FabianIDE/sports-wheelchair-project/Images/Photos/IMG_20190405_152254.jpg

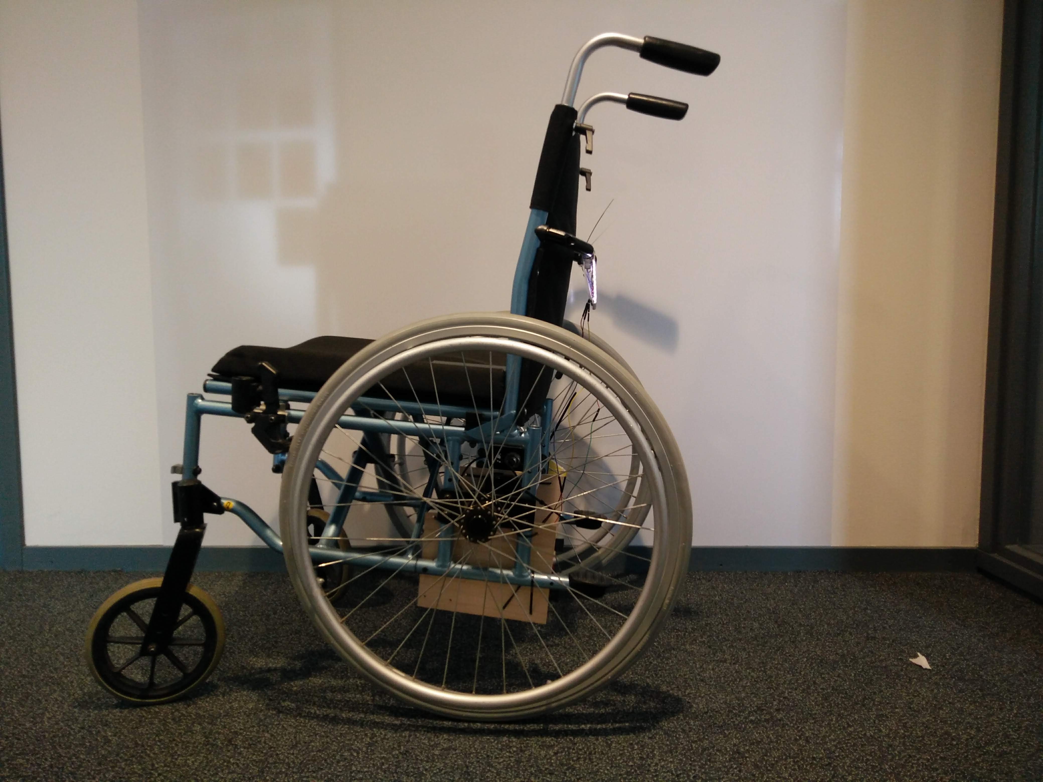
Images/Photos/IMG_20190405_152254.jpg
