FabianIDE/sports-wheelchair-project/Images/Photos/IMG_20190405_152532.jpg

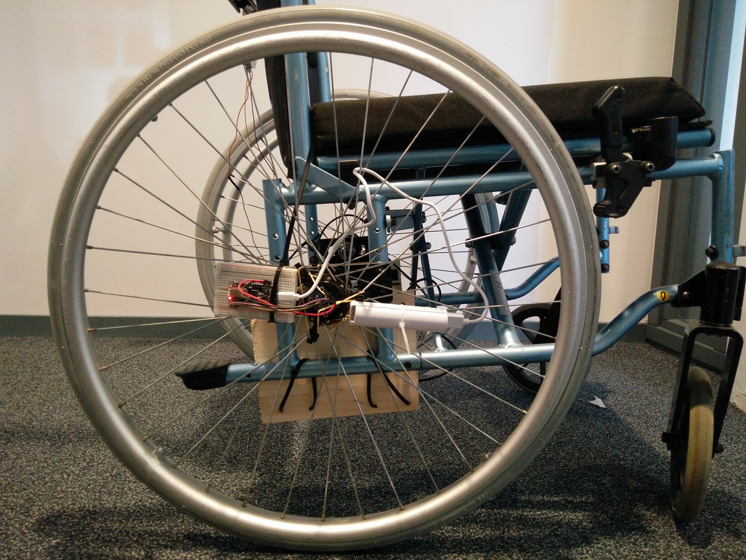
Images/Photos/IMG_20190405_152532.jpg
