FabianIDE/sports-wheelchair-project/Images/Photos/IMG_20190408_144844.jpg

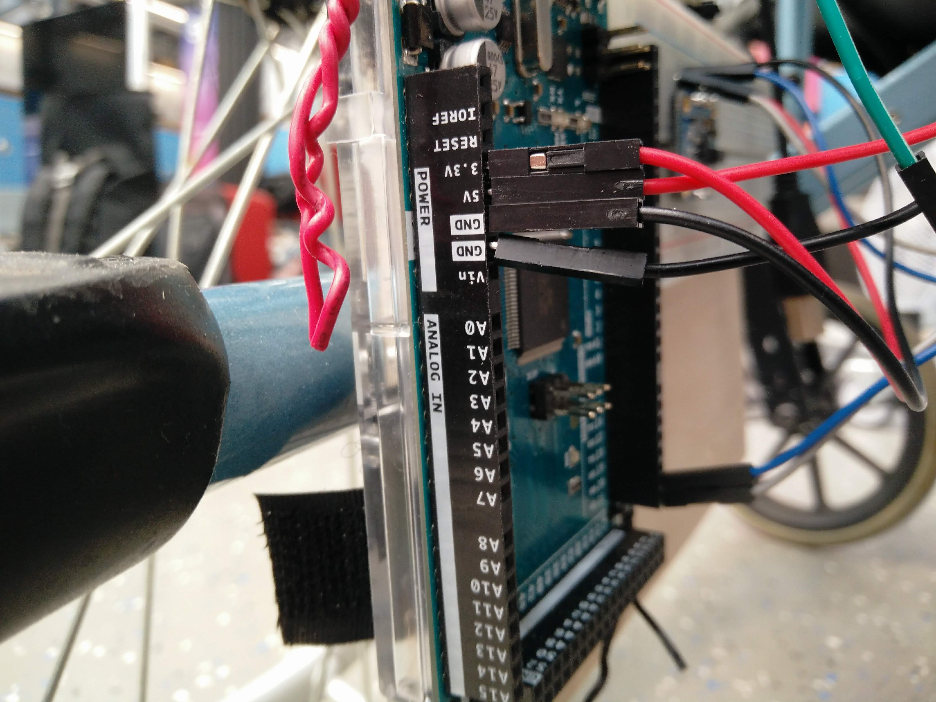
Images/Photos/IMG_20190408_144844.jpg
