FabianIDE/sports-wheelchair-project/Images/Photos/IMG_20190408_144847.jpg

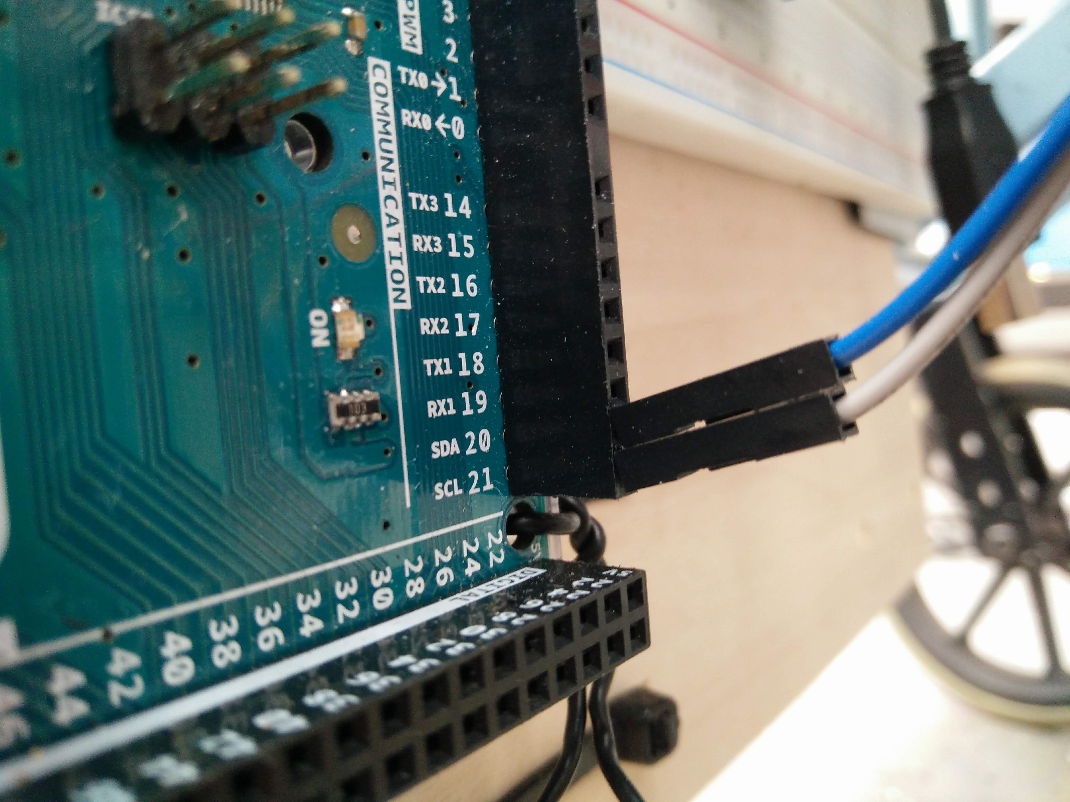
Images/Photos/IMG_20190408_144847.jpg
