FabianIDE/sports-wheelchair-project/wheelchair/magnets arduino/Arduino layout.png

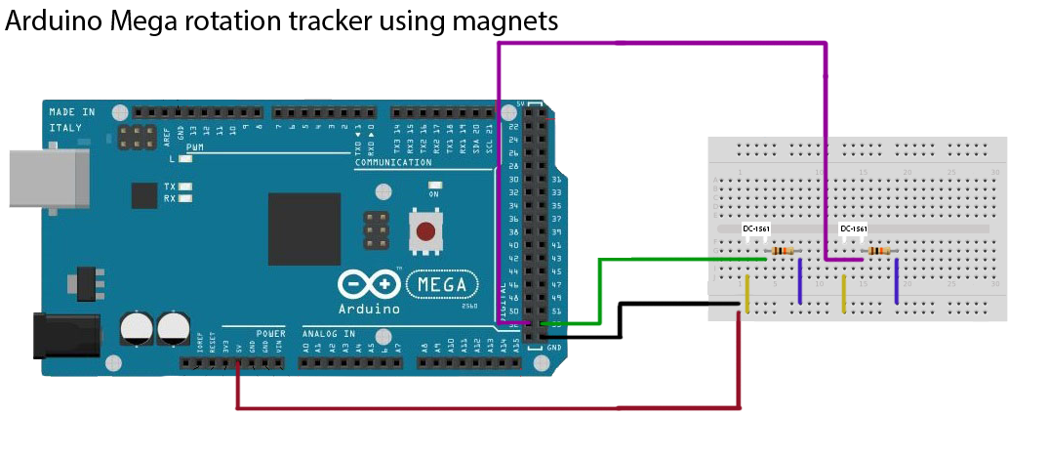
wheelchair/magnets arduino/Arduino layout.png
