FabianIDE/sports-wheelchair-project/wheelchair/magnets arduino/IMG_20190304_154146.jpg

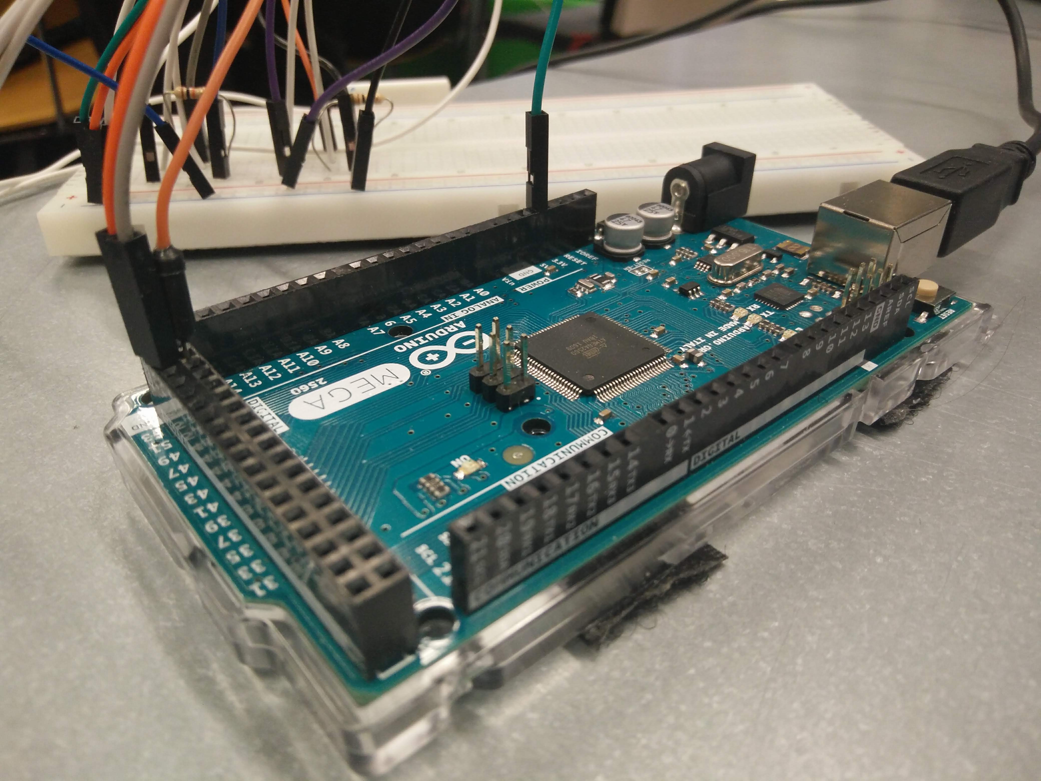
wheelchair/magnets arduino/IMG_20190304_154146.jpg
