FabianIDE/sports-wheelchair-project/INSTALLATION.md

#### MENU

[Project Description](README.md) - [Sensors & Actuators](SENSORS_ACTUATORS.md) - [Components](COMPONENTS.md) - [Installation](INSTALLATION.md) - [Testing](TESTING.md) -  [Changelog](CHANGELOG.md)

## INSTALLATION

 After collecting all the components as specified in [Components](COMPONENTS.md), follow these steps how to set everything up.

### Arduino

Download and install the (latest) Arduino software from the Arduino website (we used v 1.8.5) https://www.arduino.cc/en/Main/Software

###### Boards
The Arduino IDE already comes with everything needed for the Arduino Mega.

The Bluefruit board does need to be added manually:

Go to Tools -> Boards -> Boards Manager
Search for "bluefruit"
Install both the "adafruit AVR boards" and the "Adafruit nRF52".

Now the bluefruit should show up in your Tools -> Boards listed.

###### Libraries
In order to run the arduino sketches on this repository, the following libraries need to be install through Sketch -> Include Library -> Manage Libraries.
Search for "bluefruit nFF51" and click install.
Search for "adafruit BNO055" and click install.

###### Upload sketches
Upload the latest code in the SportsTracker_V1_Stable -> Arduino Mega folder to the Arduino Mega through the Arduino IDE.

Upload the latest code in the SportsTracker_V1_Stable -> BLE_Feather folder to the Bluefruit through the Arduino IDE.

### Raspberry Pi

Power up and connect to your Raspberry Pi in the way you prefer (i.e. over SSH or connect it to a monitor)

###### Install python requirements
Install the requirements as listed in the requirements.txt file through its terminal

```bash
pip3 install -r requirements.txt --user
```

Now install the Bluetooth dependencies for Python:

```bash
apt-get install bluez libbluetooth-dev

pip3 install git+https://github.com/peplin/pygatt

pip3 install "pygatt[GATTTOOL]"

pip3 install bluepy

pip3 install pexpect
```

###### Scan for BLE for the feather and HRM to find MAC address

We can use the command 'blescan' to scan the Bluetooth devices around. This way,you can retrieve your Feather 32u4 and the HRM (Mio link) and identify its MAC address.

```bash
sudo blescan
```

Copy the MAC addresses and paste in your .env file as a new environment variables
'BLUETOOTH_DEVICE_MAC_HRM' and 'BLUETOOTH_DEVICE_MAC_WHEEL', **for example**:

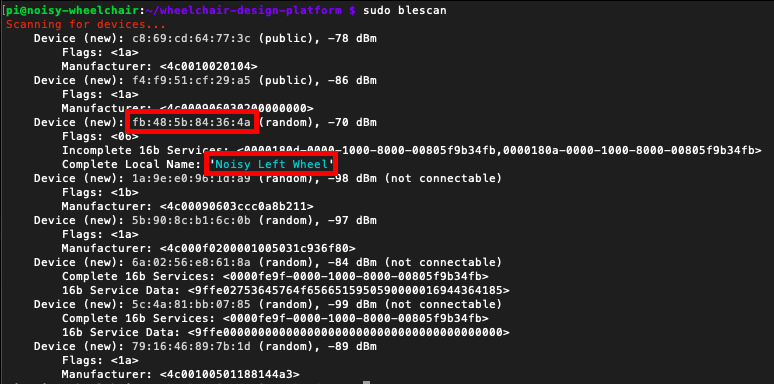
[picture p17: Archive/Course_resources/docs/workshops/images/ws2_blescan.png]
blescan


```bash
BLUETOOTH_DEVICE_MAC_HRM=C5:46:4C:2F:AD:C6
BLUETOOTH_DEVICE_MAC_WHEEL=C5:46:4C:2F:AD:C6
```

### Connecting all the components

##### On the Wheel
Connect the Bluefruit with some jumper wires to the BNO055 using this schematic:

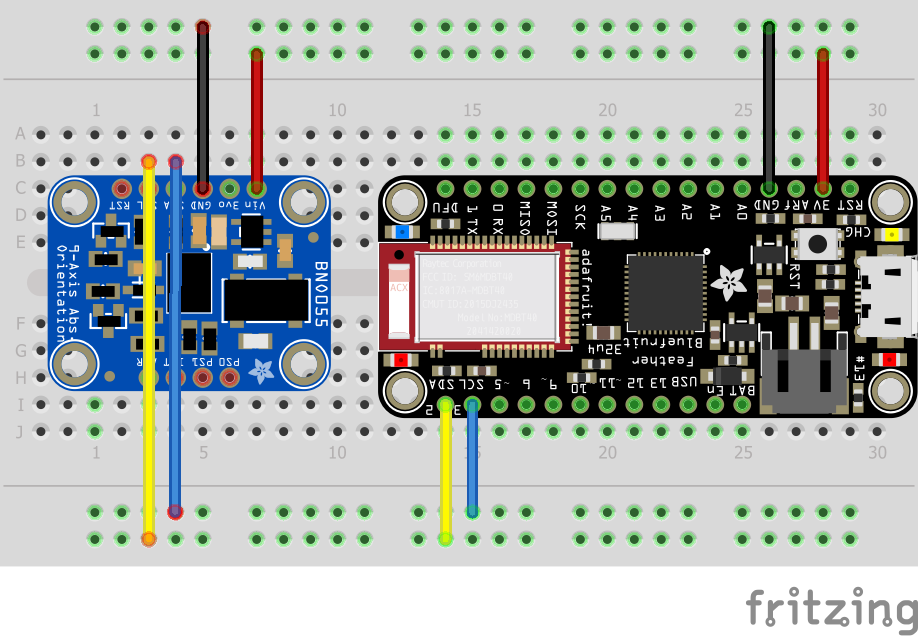
[picture p18: Images/Image 3_feather+BNO.png]


Connect the Bluefruit to the powerbank using the micro USB cable.

Now attach the whole assembly to the right wheel of the wheelchair.
**Make sure to attach the BNO055 to the center of the wheel's axle**
The result should look something like this:

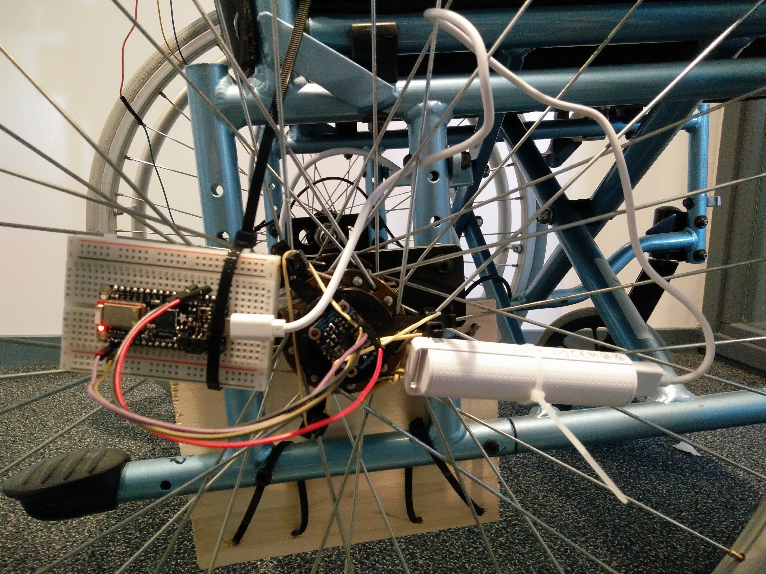
[picture p19: Images/Photos/IMG_20190405_152401.jpg]


##### On your wrist

Put the Heartbeat sensor on your wrist, then push and hold the button to turn it on.
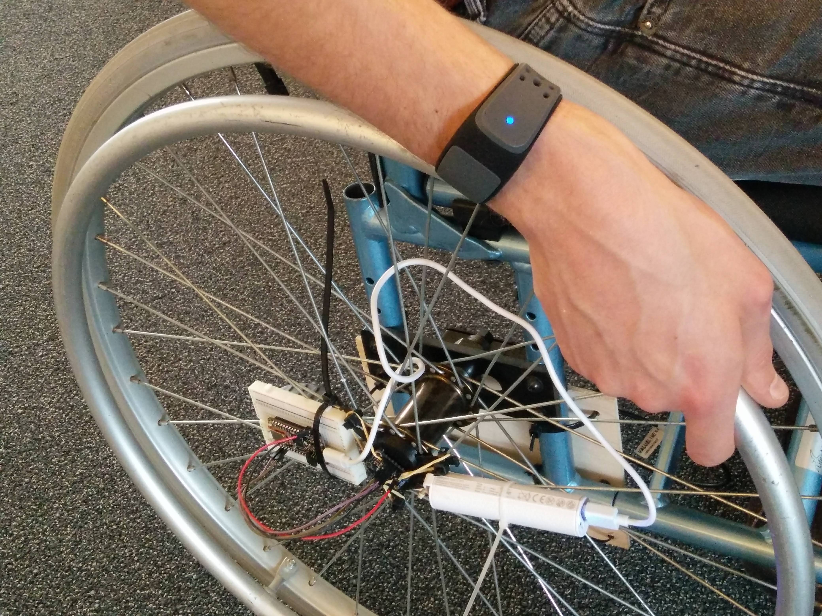
[picture p20: Images/Photos/IMG_20190405_153005.jpg]


##### Below the chair

The Arduino Mega must be connected to the other BNO055 and the LED ring. Use the following schematics to do so:

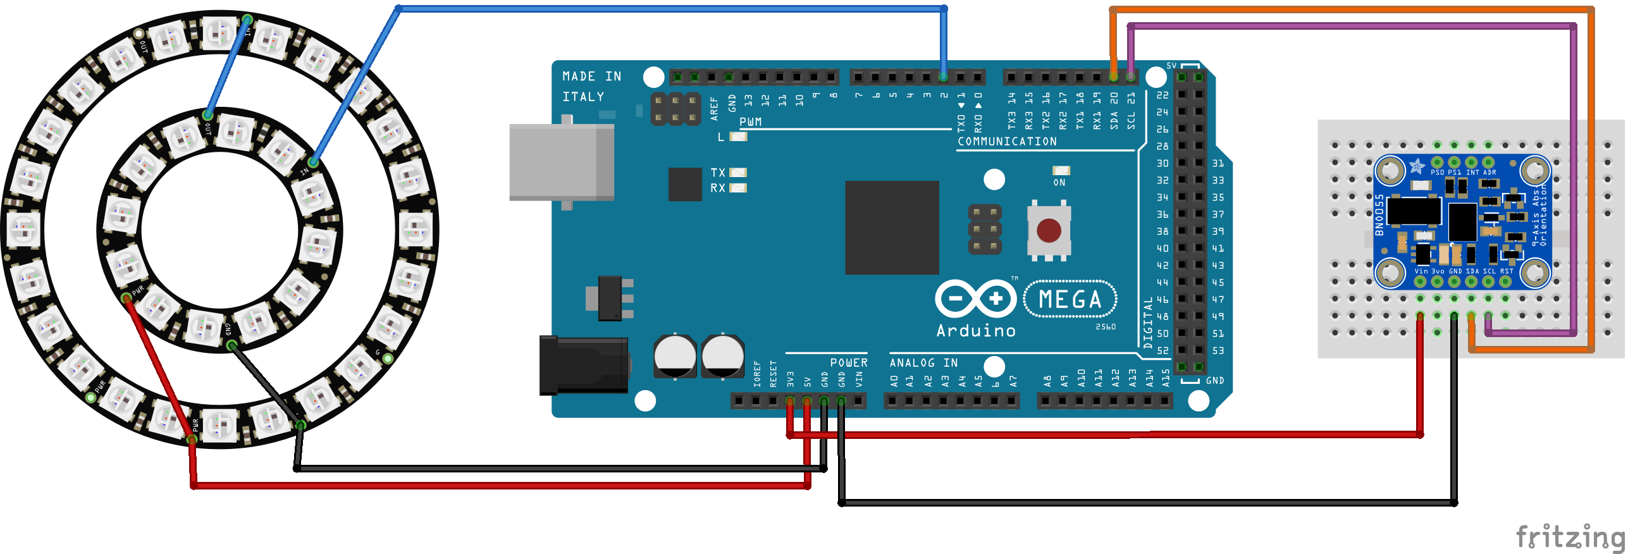
[picture p21: Images/ArduinoMega.png]


Now mount the LED ring to the back of the wheelchair and the BNO055 in the orientation shown in the picture. The location of the Arduino mega itself is not as important.

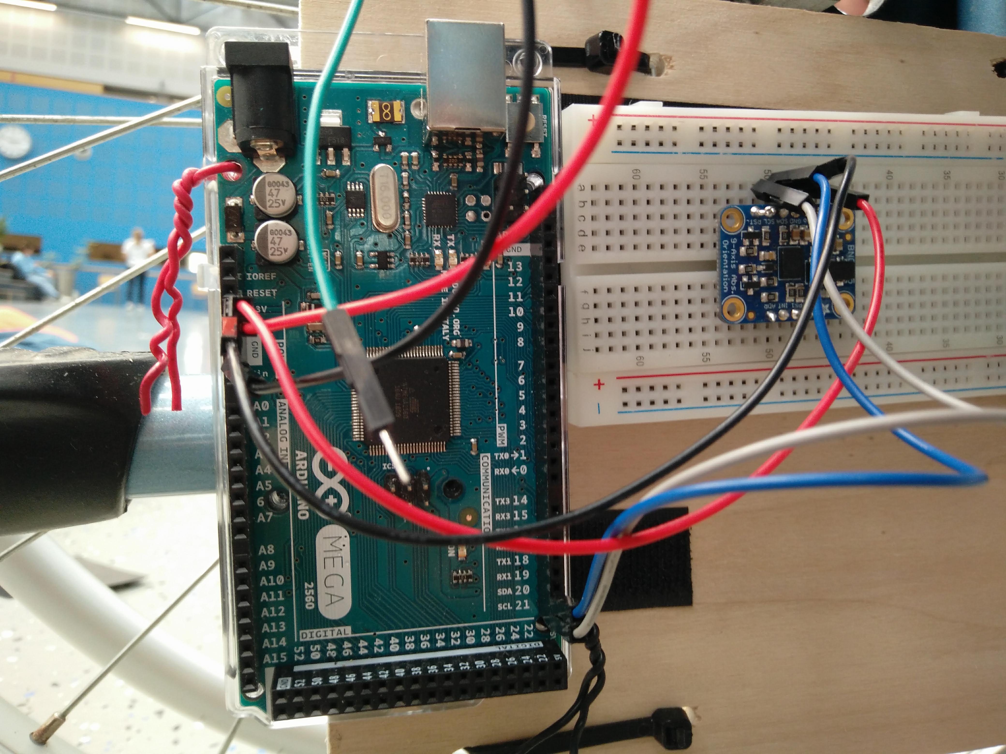
[picture p22: Images/Photos/IMG_20190408_144836.jpg]


Now mount the Raspberry Pi to the chair.
Connect the Raspberry Pi to the Arduino Mega with the USB cable
And finally mount the powerbank and connect it to the Raspberry Pi.

##### Running the Script
Make sure the Feather Bluefruit and the Heartbeat sensor is turned on.
Then run the latest SportsTracker V1_Stable/RaspberryPi -> Rpi_SportsWheelchair.py  script on the Raspberry Pi!

It should automatically detect and connect to all the peripherals. If you encounter an error or a timeout, reset the Bluefruit and the Heartbeat monitor before running the script again.
