FabianIDE/sports-wheelchair-project/TODO 15.04.2019.txt

-	Update GitHub documentation
	-	A person should be able to read and reproduce the prototype in a few hours

FABIAN
	-	Story															CHECK
	-	Video															NEEDS TO BE UPLOADED BY DANIEL
	-	Poster														CHECK
	- What tests have we done						CHECK
	- Who contributed										CHECK
	-	Github markup											CHECK
	- Github pages 											CHECK

DANIEL
	- Upload video
	- Embed video in README.md page

MAX
	-	Instructions python dependencies 	CKECK
	-	Wiring of hardware								CHECK
	-	LED RING													CHECK
	-	What is the purpose of the code
	-	Remove unnecessary code						CHECK
