FabianIDE/sports-wheelchair-project/(list of files, drawings)

Other design files:
Archive/Course_resources/docs/resources/sensors/images/force.fzz
Archive/Course_resources/docs/workshops/images/push_button_led_log.fzz
