FabianIDE/sports-wheelchair-project/wheelchair/push_button_led_log/push_button_led_log.ino

int BUTTON_PIN = 22;   // choose the input pin for the push button
int LED_PIN = 13;      // Choose the output pin for the LED

long LONG_PRESS_TIME = 500; // How long is a 'long press' (minimum, in ms)

long buttonActiveSince = 0; // Since when the button has been pressed (in ms since Arduino started)
boolean longPressActive = false; // Are we currently in a 'long press' event

void setup() {
  pinMode(BUTTON_PIN, INPUT);    // declare pushbutton as input
  pinMode(LED_PIN, OUTPUT);      // declare LED as input

  Serial.begin(9600); // setting baud speed for Serial (a baud is a pulse)


}

void loop() {
  // Is button active?
  if (digitalRead(BUTTON_PIN) == LOW) {
    // if the button was not yet pressed
    if (buttonActiveSince == 0) {
        buttonActiveSince = millis();
    } else if ((millis() - buttonActiveSince > LONG_PRESS_TIME)
                && longPressActive == false) {
      longPressActive = true;
      digitalWrite(LED_PIN, HIGH);  // turn LED ON
    }

  // Was button active?
  } else {
    // Was Long Press event?
    if (buttonActiveSince > 0) {
      // End Long Press event
      if (longPressActive == true) {
        Serial.println("button-led-0c7a,2");
        digitalWrite(LED_PIN, LOW);  // turn LED OFF
        longPressActive = false;

      // End Short Press event
      } else {
        Serial.println("button-led-0c7a,1");
      }
      buttonActiveSince = 0;
    }
  }

}
