FabianIDE/sports-wheelchair-project/(commit log)

2019-02-25 opzet van wheelchair folder -workshop1
2019-02-25 4.1 Zet in de goede folder
2019-02-25 nu met arduino in nodige map
2019-02-25 nu in de wheel chair map
2019-02-25 request sensors erbij
2019-02-26 nieuw arduino bestand
2019-03-04 Arduino mega magnets measurement
2019-03-04 Arduino magnet explanatory photos
2019-03-04 Magnets explanation
2019-03-04 Wheelchair magnet chagnes
2019-03-04 Added Actuator section.
2019-03-08 Arduino code for BNO055
2019-03-08 Added LED ring 'green light bubble' code
2019-03-08 Informatie over de maten van de rolstoel
2019-03-11 LED Ring Video, relevante afstanden update, to do list
2019-03-11 Created workshop 3 file for flashing LED ring
2019-03-11 Gyro werkend
2019-03-11 old working file - saved as wheelfeather...
2019-03-11 serial back to 9600 as arduino - rpi added debug prints
2019-03-15 Backup to prevent overwrite
    [ChairBaseV1_BACKUP.ino]
2019-03-15 new file of max to try wheel turning
2019-03-15 name change for arduino IDE..
2019-03-15 Wrote script to let LEDs blink once every X (mili)seconds
2019-03-18 removed serial prints
2019-03-18 Opruimen Wheelchair map
2019-03-18 added serial data print
2019-03-18 added debug print property
2019-03-18 more debug serial print
2019-03-18 ringDO function now takes the first and last LED to turn on
2019-03-18 print values
2019-03-18 debug print values
2019-03-18 inserted new serial code
2019-03-18 threads ble and serial
2019-03-18 remove else unknown prop
2019-03-18 Inserted HRM code
2019-03-18 added serial to arduino line + HRM keyboard interupt
2019-03-18 print hrm intvalue
2019-03-18 added str to serial to arduino
2019-03-18 yet another comma tryout. for some last ones the arduino did not get delayed so the turn signals still worked.
2019-03-18 missed brackets at .encode()
2019-03-18 added a 2 sec sleep after opening serial to let arduino boot
2019-03-18 removed the brackets from the HRM intvalue!
2019-03-18 hrm value is send with brackets to server , without to serial
2019-03-25 added calibration of wheelie angle + added Acc X
2019-03-25 added correct serial prints after testing wheelie meter
    [ChairBaseV3.0.0.ino]
2019-04-01 print Arbeid
2019-04-01 arbeid print change
2019-04-01 Thing ipv thing want het is een class
2019-04-01 Added Wheelie indicator (police theme)
2019-04-01 change of wheel property
2019-04-01 included draft fitness metering and printin and Kcaltotal inactivity counter
2019-04-01 removed debug prints giving errors
2019-04-01 Debug print serial.writes
2019-04-01 changed all deltaX values to float, as they were too small for ints
    [ChairBaseV3.3.0.ino]
2019-04-02 removed sending gyro. now sending speed of wheel
2019-04-15 Clean up the wheelchair repo
2019-04-15 sidebar proberen te maken
